OpenGK-org/ecu-reverse-engineering/5wy19/MCU.kicad_sch

## KiCad design 5wy19/MCU.kicad_sch (2025-10-28)

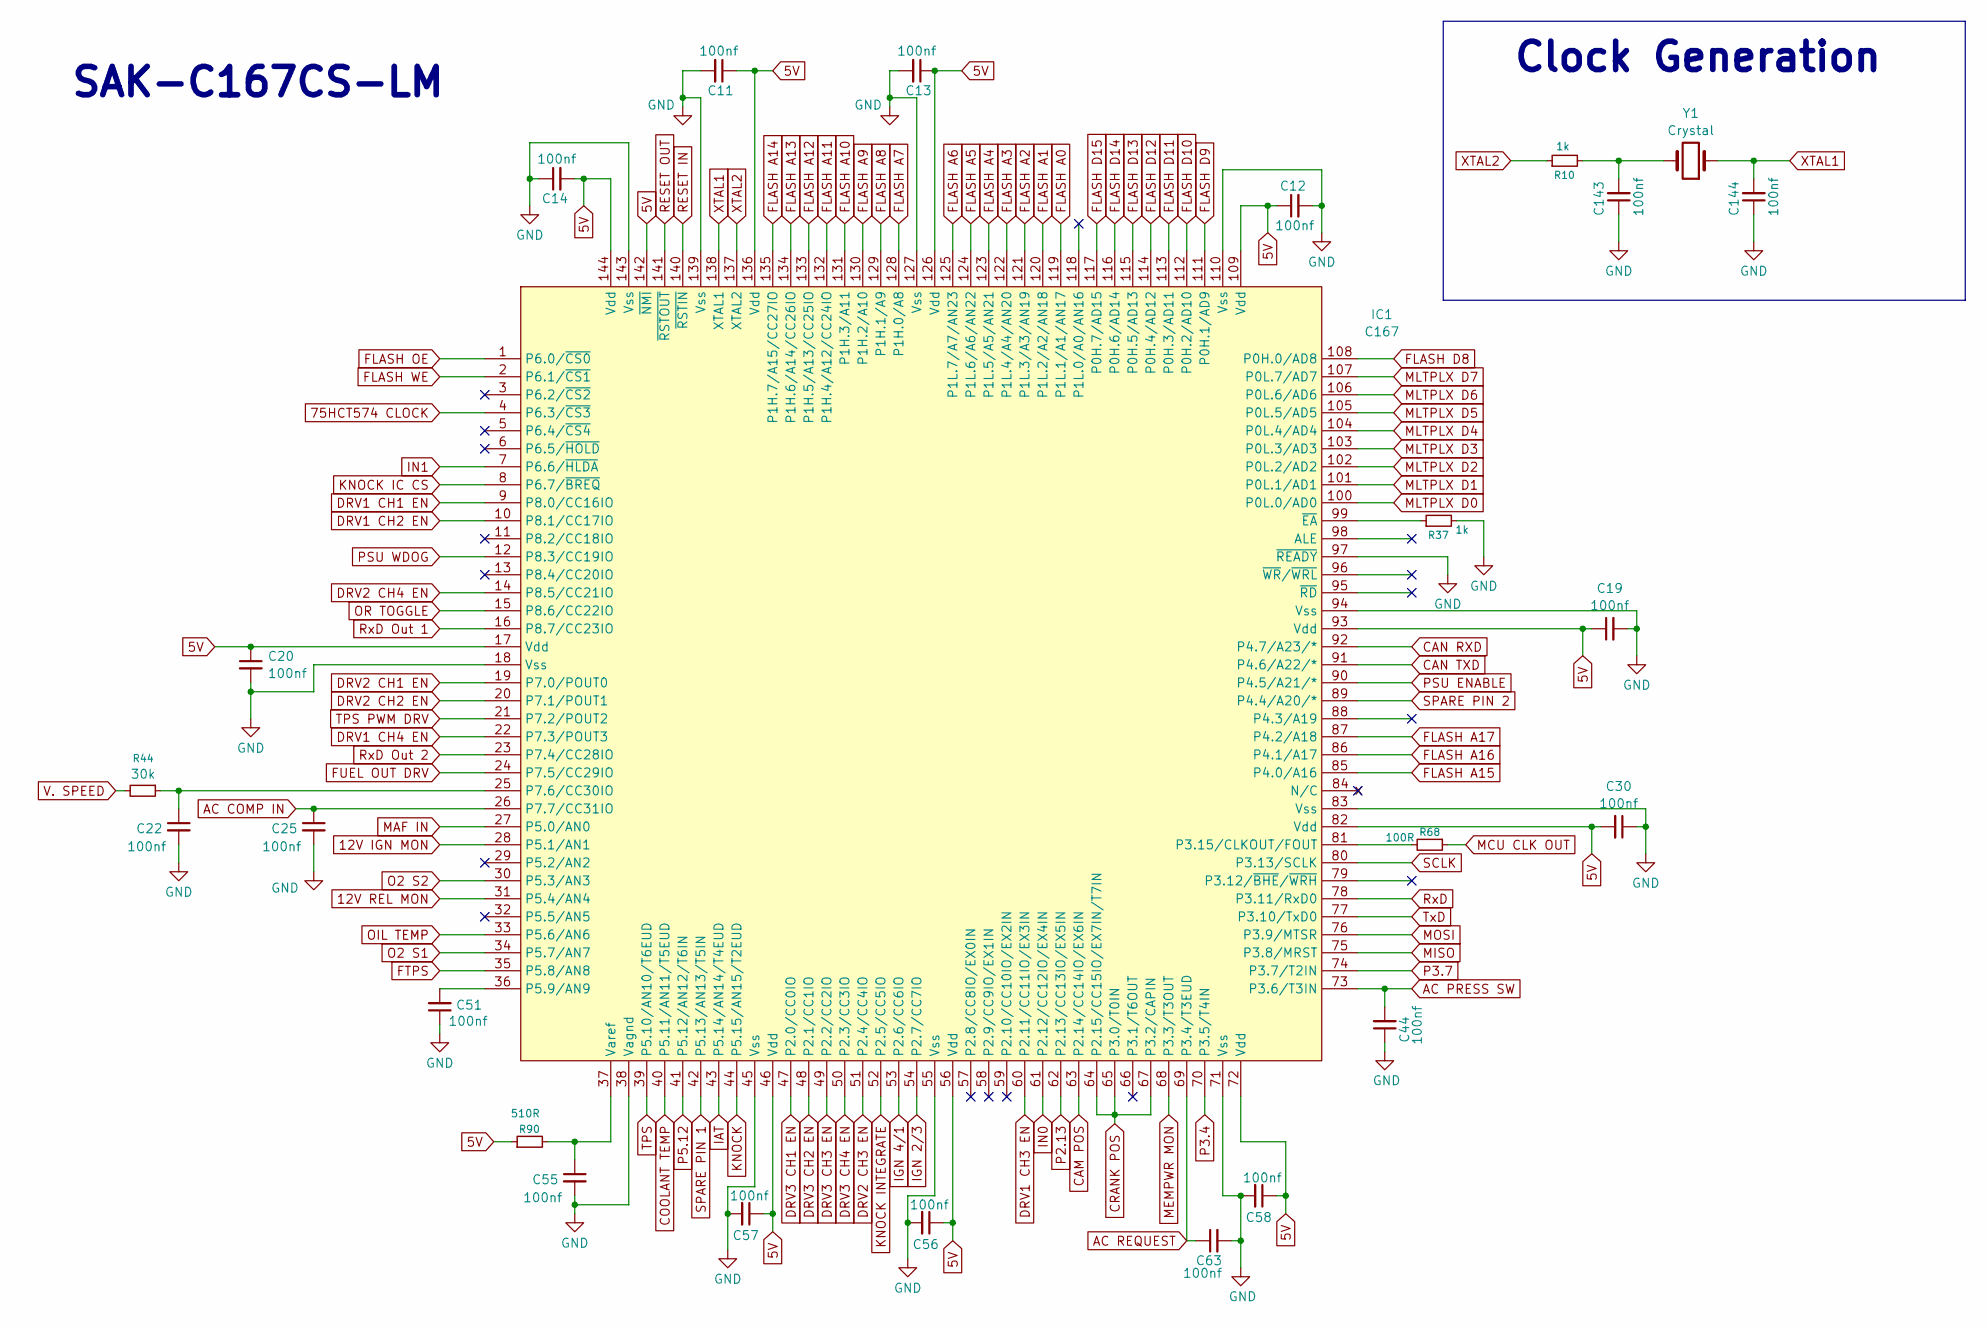
[picture p1: schematic MCU.kicad_sch]

Parts:
C11, C12, C13, C14, C19, C20, C22, C25, C30, C44, C51, C55, C56, C57, C58, C63, C143, C144: 100nf
IC1: C167
R10, R37: 1k
R44: 30k
R68: 100R
R90: 510R
Y1: Crystal

Connections:
5V: C11.1, C12.1, C13.1, C14.2, C19.1, C20.1, C30.2, C56.1, C57.1, C58.1, IC1.17 (Vdd), IC1.46 (Vdd), IC1.56 (Vdd), IC1.72 (Vdd), IC1.82 (Vdd), IC1.93 (Vdd), IC1.109 (Vdd), IC1.126 (Vdd), IC1.136 (Vdd), IC1.142 (~NMI), IC1.144 (Vdd), R90.1
12V IGN MON: IC1.28 (P5.1/AN1)
12V REL MON: IC1.31 (P5.4/AN4)
75HCT574 CLOCK: IC1.4 (P6.3/~CS3)
AC COMP IN: C25.1, IC1.26 (P7.7/CC31IO)
AC PRESS SW: C44.2, IC1.73 (P3.6/T3IN)
AC REQUEST: C63.1, IC1.69 (P3.4/T3EUD)
CAM POS: IC1.63 (P2.14/CC14IO/EX6IN)
CAN RXD: IC1.92 (P4.7/A23/*)
CAN TXD: IC1.91 (P4.6/A22/*)
COOLANT TEMP: IC1.40 (P5.11/AN11/T5EUD)
CRANK POS: IC1.64 (P2.15/CC15IO/EX7IN/T7IN), IC1.65 (P3.0/T0IN), IC1.67 (P3.2/CAPIN)
DRV1 CH1 EN: IC1.9 (P8.0/CC16IO)
DRV1 CH2 EN: IC1.10 (P8.1/CC17IO)
DRV1 CH3 EN: IC1.60 (P2.11/CC11IO/EX3IN)
DRV1 CH4 EN: IC1.22 (P7.3/POUT3)
DRV2 CH1 EN: IC1.19 (P7.0/POUT0)
DRV2 CH2 EN: IC1.20 (P7.1/POUT1)
DRV2 CH3 EN: IC1.51 (P2.4/CC4IO)
DRV2 CH4 EN: IC1.14 (P8.5/CC21IO)
DRV3 CH1 EN: IC1.47 (P2.0/CC0IO)
DRV3 CH2 EN: IC1.48 (P2.1/CC1IO)
DRV3 CH3 EN: IC1.49 (P2.2/CC2IO)
DRV3 CH4 EN: IC1.50 (P2.3/CC3IO)
FLASH A0: IC1.119 (P1L.1/A1/AN17)
FLASH A1: IC1.120 (P1L.2/A2/AN18)
FLASH A2: IC1.121 (P1L.3/A3/AN19)
FLASH A3: IC1.122 (P1L.4/A4/AN20)
FLASH A4: IC1.123 (P1L.5/A5/AN21)
FLASH A5: IC1.124 (P1L.6/A6/AN22)
FLASH A6: IC1.125 (P1L.7/A7/AN23)
FLASH A7: IC1.128 (P1H.0/A8)
FLASH A8: IC1.129 (P1H.1/A9)
FLASH A9: IC1.130 (P1H.2/A10)
FLASH A10: IC1.131 (P1H.3/A11)
FLASH A11: IC1.132 (P1H.4/A12/CC24IO)
FLASH A12: IC1.133 (P1H.5/A13/CC25IO)
FLASH A13: IC1.134 (P1H.6/A14/CC26IO)
FLASH A14: IC1.135 (P1H.7/A15/CC27IO)
FLASH A15: IC1.85 (P4.0/A16)
FLASH A16: IC1.86 (P4.1/A17)
FLASH A17: IC1.87 (P4.2/A18)
FLASH D8: IC1.108 (P0H.0/AD8)
FLASH D9: IC1.111 (P0H.1/AD9)
FLASH D10: IC1.112 (P0H.2/AD10)
FLASH D11: IC1.113 (P0H.3/AD11)
FLASH D12: IC1.114 (P0H.4/AD12)
FLASH D13: IC1.115 (P0H.5/AD13)
FLASH D14: IC1.116 (P0H.6/AD14)
FLASH D15: IC1.117 (P0H.7/AD15)
FLASH OE: IC1.1 (P6.0/~CS0)
FLASH WE: IC1.2 (P6.1/~CS1)
FTPS: IC1.35 (P5.8/AN8)
FUEL OUT DRV: IC1.24 (P7.5/CC29IO)
GND: C11.2, C12.2, C13.2, C14.1, C19.2, C20.2, C22.2, C25.2, C30.1, C44.1, C51.1, C55.2, C56.2, C57.2, C58.2, C63.2, C143.1, C144.1, IC1.18 (Vss), IC1.38 (Vagnd), IC1.45 (Vss), IC1.55 (Vss), IC1.71 (Vss), IC1.83 (Vss), IC1.94 (Vss), IC1.97 (~READY), IC1.110 (Vss), IC1.127 (Vss), IC1.139 (Vss), IC1.143 (Vss), R37.2
IAT: IC1.43 (P5.14/AN14/T4EUD)
IGN 2/3: IC1.54 (P2.7/CC7IO)
IGN 4/1: IC1.53 (P2.6/CC6IO)
IN0: IC1.61 (P2.12/CC12IO/EX4IN)
IN1: IC1.7 (P6.6/~HLDA)
KNOCK: IC1.44 (P5.15/AN15/T2EUD)
KNOCK IC CS: IC1.8 (P6.7/~BREQ)
KNOCK INTEGRATE: IC1.52 (P2.5/CC5IO)
MAF IN: IC1.27 (P5.0/AN0)
MCU CLK OUT: R68.1
MEMPWR MON: IC1.68 (P3.3/T3OUT)
MISO: IC1.75 (P3.8/MRST)
MLTPLX D0: IC1.100 (P0L.0/AD0)
MLTPLX D1: IC1.101 (P0L.1/AD1)
MLTPLX D2: IC1.102 (P0L.2/AD2)
MLTPLX D3: IC1.103 (P0L.3/AD3)
MLTPLX D4: IC1.104 (P0L.4/AD4)
MLTPLX D5: IC1.105 (P0L.5/AD5)
MLTPLX D6: IC1.106 (P0L.6/AD6)
MLTPLX D7: IC1.107 (P0L.7/AD7)
MOSI: IC1.76 (P3.9/MTSR)
unnamed: C22.1, IC1.25 (P7.6/CC30IO), R44.1
unnamed: C51.2, IC1.36 (P5.9/AN9)
unnamed: C55.1, IC1.37 (Varef), R90.2
unnamed: C143.2, R10.2, Y1.2
unnamed: IC1.81 (P3.15/CLKOUT/FOUT), R68.2
unnamed: IC1.99 (~EA), R37.1
O2 S1: IC1.34 (P5.7/AN7)
O2 S2: IC1.30 (P5.3/AN3)
OIL TEMP: IC1.33 (P5.6/AN6)
OR TOGGLE: IC1.15 (P8.6/CC22IO)
P2.13: IC1.62 (P2.13/CC13IO/EX5IN)
P3.4: IC1.70 (P3.5/T4IN)
P3.7: IC1.74 (P3.7/T2IN)
P5.12: IC1.41 (P5.12/AN12/T6IN)
PSU ENABLE: IC1.90 (P4.5/A21/*)
PSU WDOG: IC1.12 (P8.3/CC19IO)
RESET IN: IC1.140 (~RSTIN)
RESET OUT: IC1.141 (~RSTOUT)
RxD: IC1.78 (P3.11/RxD0)
RxD Out 1: IC1.16 (P8.7/CC23IO)
RxD Out 2: IC1.23 (P7.4/CC28IO)
SCLK: IC1.80 (P3.13/SCLK)
SPARE PIN 1: IC1.42 (P5.13/AN13/T5IN)
SPARE PIN 2: IC1.89 (P4.4/A20/*)
TPS: IC1.39 (P5.10/AN10/T6EUD)
TPS PWM DRV: IC1.21 (P7.2/POUT2)
TxD: IC1.77 (P3.10/TxD0)
V. SPEED: R44.2
XTAL1: C144.2, IC1.138 (XTAL1), Y1.1
XTAL2: IC1.137 (XTAL2), R10.1

Notes on the sheet:
Clock Generation
SAK-C167CS-LM
