OpenGK-org/ecu-reverse-engineering/5wy19/can.kicad_sch

## KiCad design 5wy19/can.kicad_sch (2025-10-28)

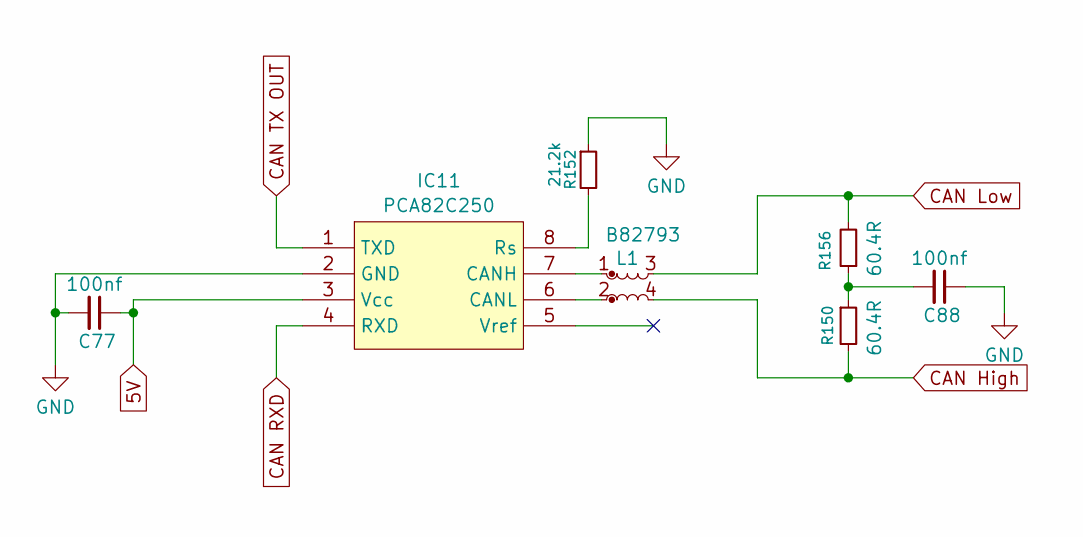
[picture p2: schematic can.kicad_sch]

Parts:
C77, C88: 100nf
IC11: PCA82C250
L1: B82793
R150, R156: 60.4R
R152: 21.2k

Connections:
5V: C77.1, IC11.3 (Vcc)
CAN High: L1.4, R150.2
CAN Low: L1.3, R156.2
CAN RXD: IC11.4 (RXD)
CAN TX OUT: IC11.1 (TXD)
GND: C77.2, C88.1, IC11.2 (GND), R152.1
unnamed: C88.2, R150.1, R156.1
unnamed: IC11.6 (CANL), L1.2
unnamed: IC11.7 (CANH), L1.1
unnamed: IC11.8 (Rs), R152.2
