OpenGK-org/ecu-reverse-engineering/5wy19/connector.kicad_sch

## KiCad design 5wy19/connector.kicad_sch (2025-10-28)

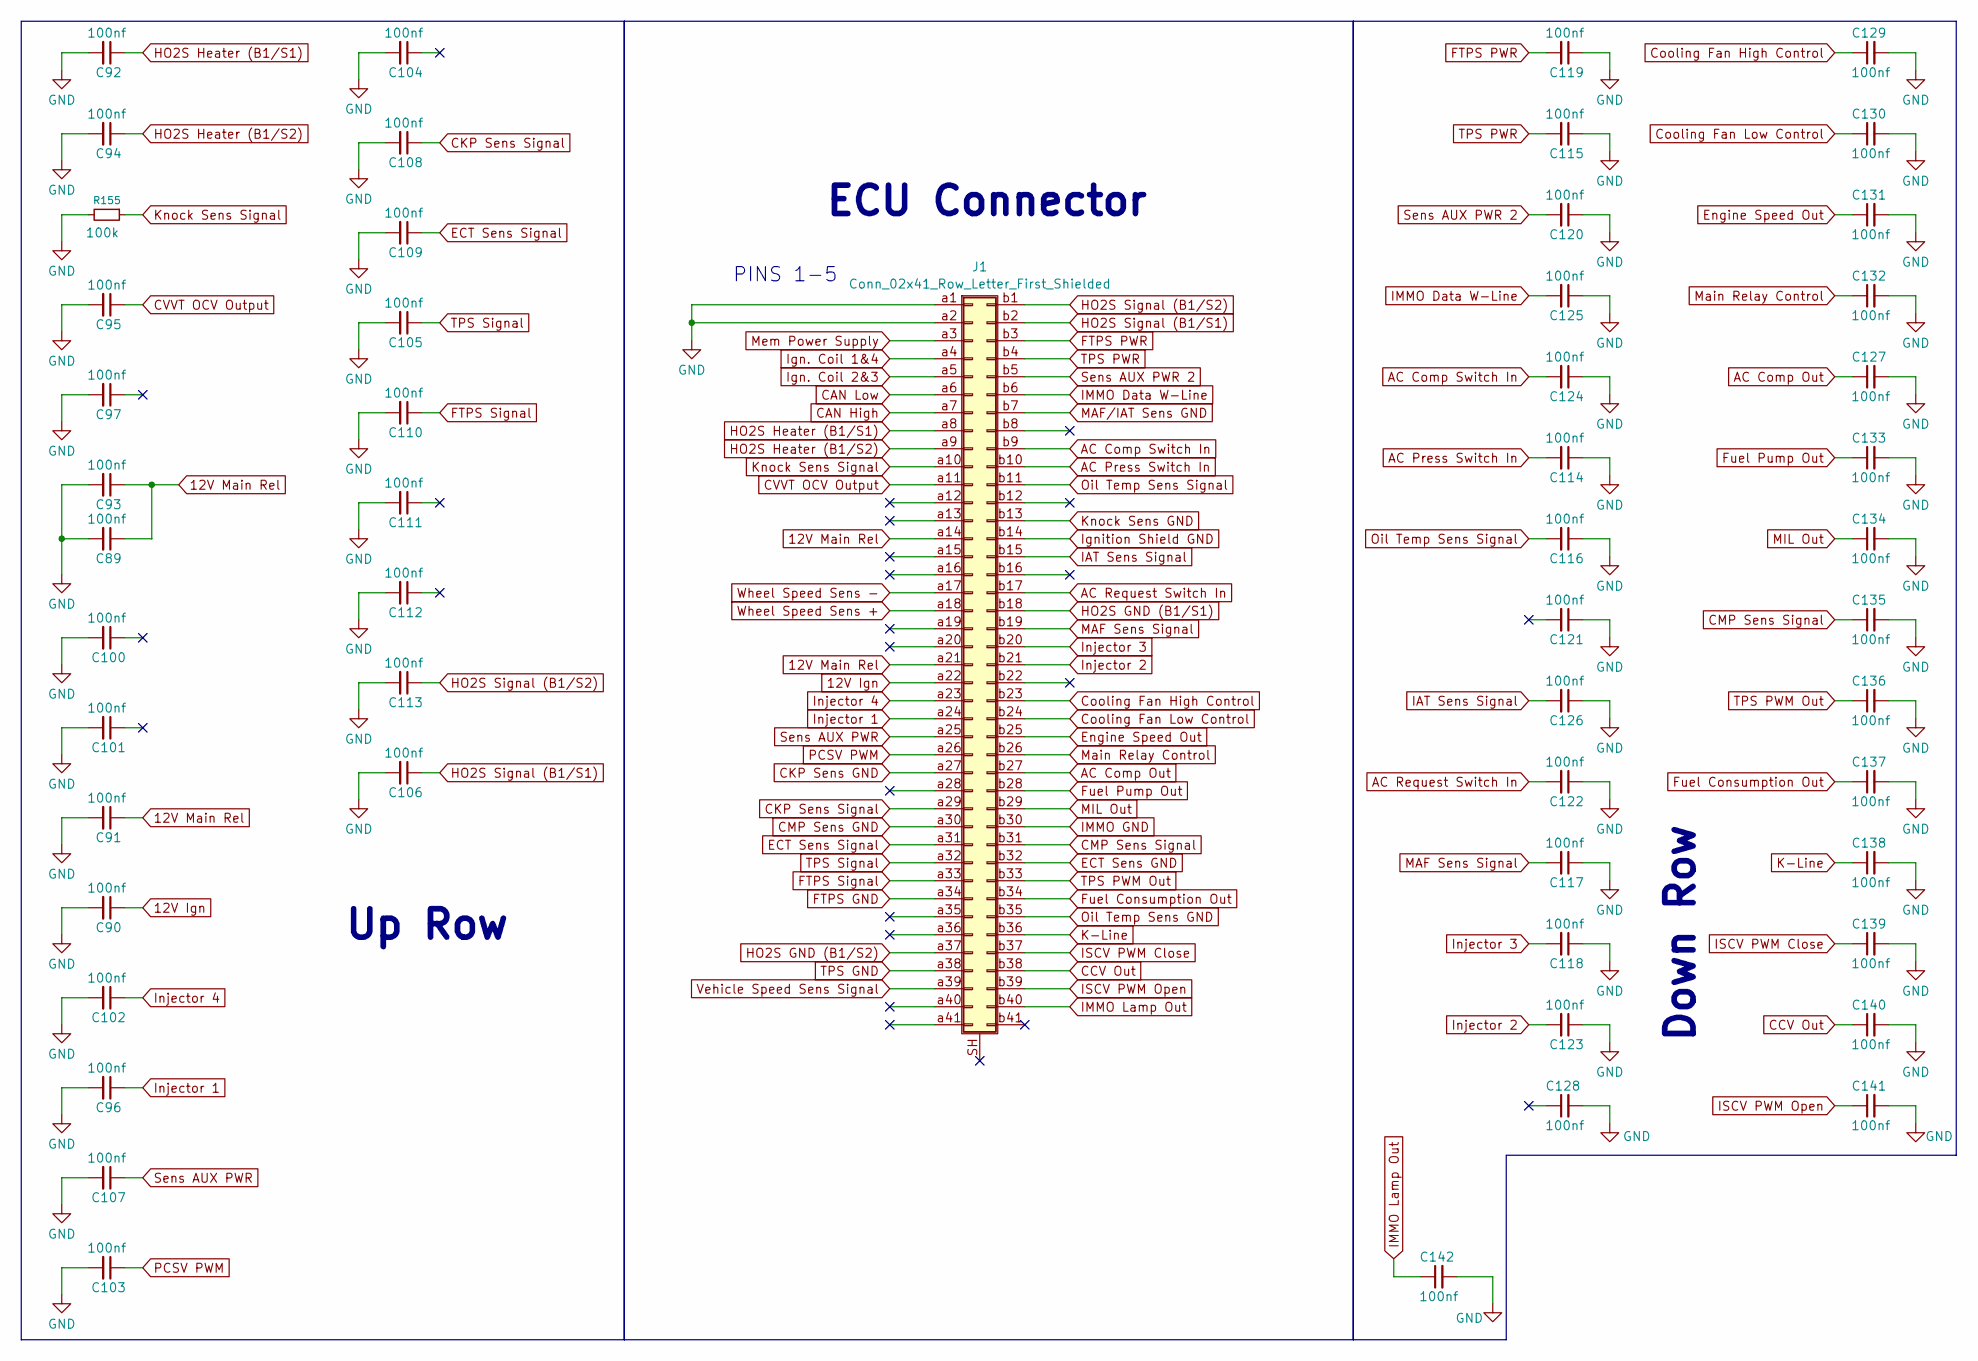
[picture p3: schematic connector.kicad_sch]

Parts:
C89, C90, C91, C92, C93, C94, C95, C96, C97, C100, C101, C102, C103, C104, C105, C106, C107, C108, C109, C110, C111, C112, C113, C114, C115, C116, C117, C118, C119, C120, C121, C122, C123, C124, C125, C126, C127, C128, C129, C130, C131, C132, C133, C134, C135, C136, C137, C138, C139, C140, C141, C142: 100nf
J1: Conn_02x41_Row_Letter_First_Shielded
R155: 100k

Connections:
12V Ign: C90.1, J1.a22
12V Main Rel: C89.1, C91.1, C93.1, J1.a14, J1.a21
AC Comp Out: C127.1, J1.b27
AC Comp Switch In: C124.2, J1.b9
AC Press Switch In: C114.2, J1.b10
AC Request Switch In: C122.2, J1.b17
CAN High: J1.a7
CAN Low: J1.a6
CCV Out: C140.1, J1.b38
CKP Sens GND: J1.a27
CKP Sens Signal: C108.1, J1.a29
CMP Sens GND: J1.a30
CMP Sens Signal: C135.1, J1.b31
CVVT OCV Output: C95.1, J1.a11
Cooling Fan High Control: C129.1, J1.b23
Cooling Fan Low Control: C130.1, J1.b24
ECT Sens GND: J1.b32
ECT Sens Signal: C109.1, J1.a31
Engine Speed Out: C131.1, J1.b25
FTPS GND: J1.a34
FTPS PWR: C119.2, J1.b3
FTPS Signal: C110.1, J1.a33
Fuel Consumption Out: C137.1, J1.b34
Fuel Pump Out: C133.1, J1.b28
GND: C89.2, C90.2, C91.2, C92.2, C93.2, C94.2, C95.2, C96.2, C97.2, C100.2, C101.2, C102.2, C103.2, C104.2, C105.2, C106.2, C107.2, C108.2, C109.2, C110.2, C111.2, C112.2, C113.2, C114.1, C115.1, C116.1, C117.1, C118.1, C119.1, C120.1, C121.1, C122.1, C123.1, C124.1, C125.1, C126.1, C127.2, C128.2, C129.2, C130.2, C131.2, C132.2, C133.2, C134.2, C135.2, C136.2, C137.2, C138.2, C139.2, C140.2, C141.2, C142.2, J1.a1, J1.a2, R155.2
HO2S GND (B1/S1): J1.b18
HO2S GND (B1/S2): J1.a37
HO2S Heater (B1/S1): C92.1, J1.a8
HO2S Heater (B1/S2): C94.1, J1.a9
HO2S Signal (B1/S1): C106.1, J1.b2
HO2S Signal (B1/S2): C113.1, J1.b1
IAT Sens Signal: C126.2, J1.b15
IMMO Data W-Line: C125.2, J1.b6
IMMO GND: J1.b30
IMMO Lamp Out: C142.1, J1.b40
ISCV PWM Close: C139.1, J1.b37
ISCV PWM Open: C141.1, J1.b39
Ign. Coil 1&4: J1.a4
Ign. Coil 2&3: J1.a5
Ignition Shield GND: J1.b14
Injector 1: C96.1, J1.a24
Injector 2: C123.2, J1.b21
Injector 3: C118.2, J1.b20
Injector 4: C102.1, J1.a23
K-Line: C138.1, J1.b36
Knock Sens GND: J1.b13
Knock Sens Signal: J1.a10, R155.1
MAF Sens Signal: C117.2, J1.b19
MAF/IAT Sens GND: J1.b7
MIL Out: C134.1, J1.b29
Main Relay Control: C132.1, J1.b26
Mem Power Supply: J1.a3
Oil Temp Sens GND: J1.b35
Oil Temp Sens Signal: C116.2, J1.b11
PCSV PWM: C103.1, J1.a26
Sens AUX PWR: C107.1, J1.a25
Sens AUX PWR 2: C120.2, J1.b5
TPS GND: J1.a38
TPS PWM Out: C136.1, J1.b33
TPS PWR: C115.2, J1.b4
TPS Signal: C105.1, J1.a32
Vehicle Speed Sens Signal: J1.a39
Wheel Speed Sens +: J1.a18
Wheel Speed Sens -: J1.a17

Notes on the sheet:
ECU Connector
PINS 1-5
Up Row
Down Row
