OpenGK-org/ecu-reverse-engineering/5wy19/flash.kicad_sch

## KiCad design 5wy19/flash.kicad_sch (2025-10-28)

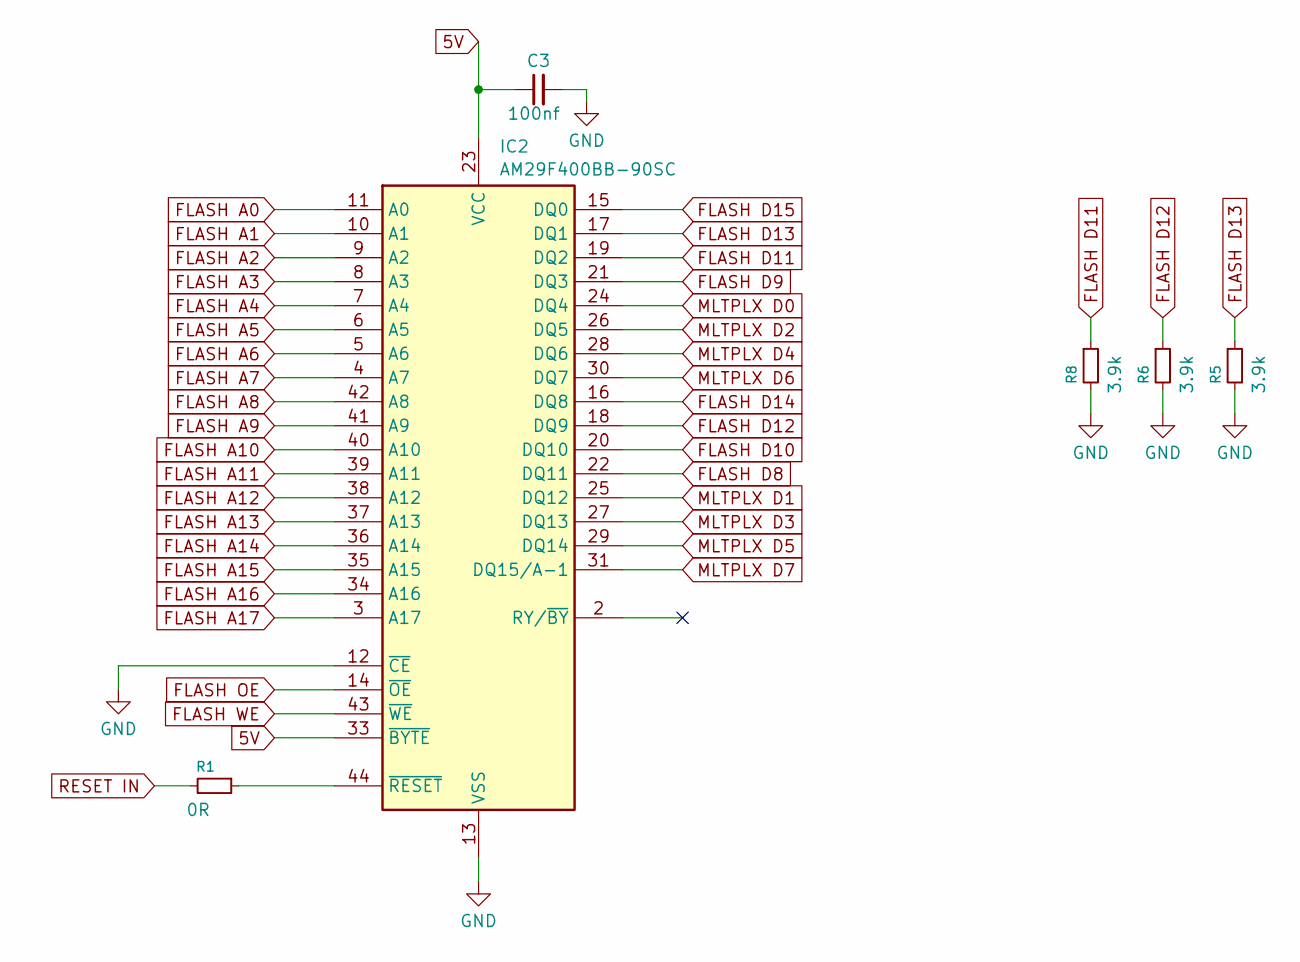
[picture p4: schematic flash.kicad_sch]

Parts:
C3: 100nf
IC2: AM29F400BB-90SC; SOP-44_13.3x28.2mm_P1.27mm
R1: 0R
R5, R6, R8: 3.9k

Connections:
5V: C3.1, IC2.23 (VCC), IC2.33 (~BYTE)
FLASH A0: IC2.11 (A0)
FLASH A1: IC2.10 (A1)
FLASH A2: IC2.9 (A2)
FLASH A3: IC2.8 (A3)
FLASH A4: IC2.7 (A4)
FLASH A5: IC2.6 (A5)
FLASH A6: IC2.5 (A6)
FLASH A7: IC2.4 (A7)
FLASH A8: IC2.42 (A8)
FLASH A9: IC2.41 (A9)
FLASH A10: IC2.40 (A10)
FLASH A11: IC2.39 (A11)
FLASH A12: IC2.38 (A12)
FLASH A13: IC2.37 (A13)
FLASH A14: IC2.36 (A14)
FLASH A15: IC2.35 (A15)
FLASH A16: IC2.34 (A16)
FLASH A17: IC2.3 (A17)
FLASH D8: IC2.22 (DQ11)
FLASH D9: IC2.21 (DQ3)
FLASH D10: IC2.20 (DQ10)
FLASH D11: IC2.19 (DQ2), R8.1
FLASH D12: IC2.18 (DQ9), R6.1
FLASH D13: IC2.17 (DQ1), R5.1
FLASH D14: IC2.16 (DQ8)
FLASH D15: IC2.15 (DQ0)
FLASH OE: IC2.14 (~OE)
FLASH WE: IC2.43 (~WE)
GND: C3.2, IC2.12 (~CE), IC2.13 (VSS), IC2.32 (VSS), R5.2, R6.2, R8.2
MLTPLX D0: IC2.24 (DQ4)
MLTPLX D1: IC2.25 (DQ12)
MLTPLX D2: IC2.26 (DQ5)
MLTPLX D3: IC2.27 (DQ13)
MLTPLX D4: IC2.28 (DQ6)
MLTPLX D5: IC2.29 (DQ14)
MLTPLX D6: IC2.30 (DQ7)
MLTPLX D7: IC2.31 (DQ15/A-1)
unnamed: IC2.44 (~RESET), R1.1
RESET IN: R1.2
