OpenGK-org/ecu-reverse-engineering/5wy19/igadrv.kicad_sch

## KiCad design 5wy19/igadrv.kicad_sch (2025-10-28)

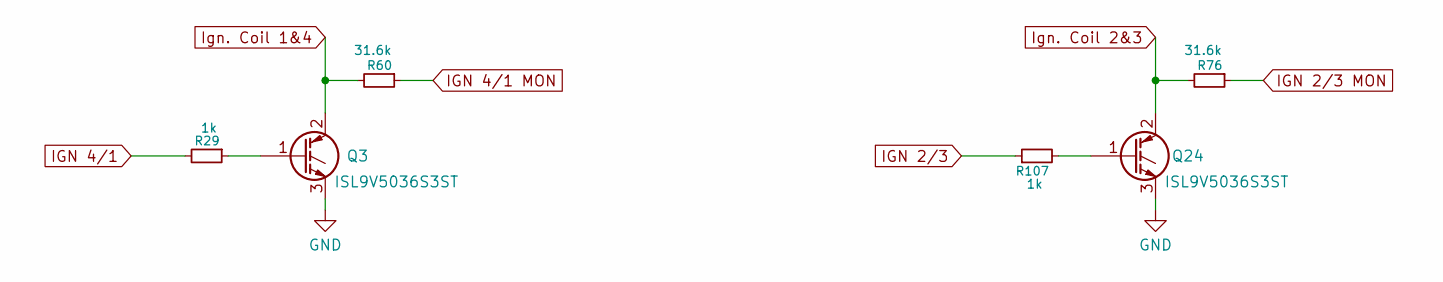
[picture p5: schematic igadrv.kicad_sch]

Parts:
Q3, Q24: ISL9V5036S3ST
R29, R107: 1k
R60, R76: 31.6k

Connections:
GND: Q3.3 (E), Q24.3 (E)
IGN 2/3: R107.1
IGN 2/3 MON: R76.1
IGN 4/1: R29.2
IGN 4/1 MON: R60.1
Ign. Coil 1&4: Q3.2 (C), R60.2
Ign. Coil 2&3: Q24.2 (C), R76.2
unnamed: Q3.1 (G), R29.1
unnamed: Q24.1 (G), R107.2
