OpenGK-org/ecu-reverse-engineering/5wy19/iodriv.kicad_sch

## KiCad design 5wy19/iodriv.kicad_sch (2025-10-28)

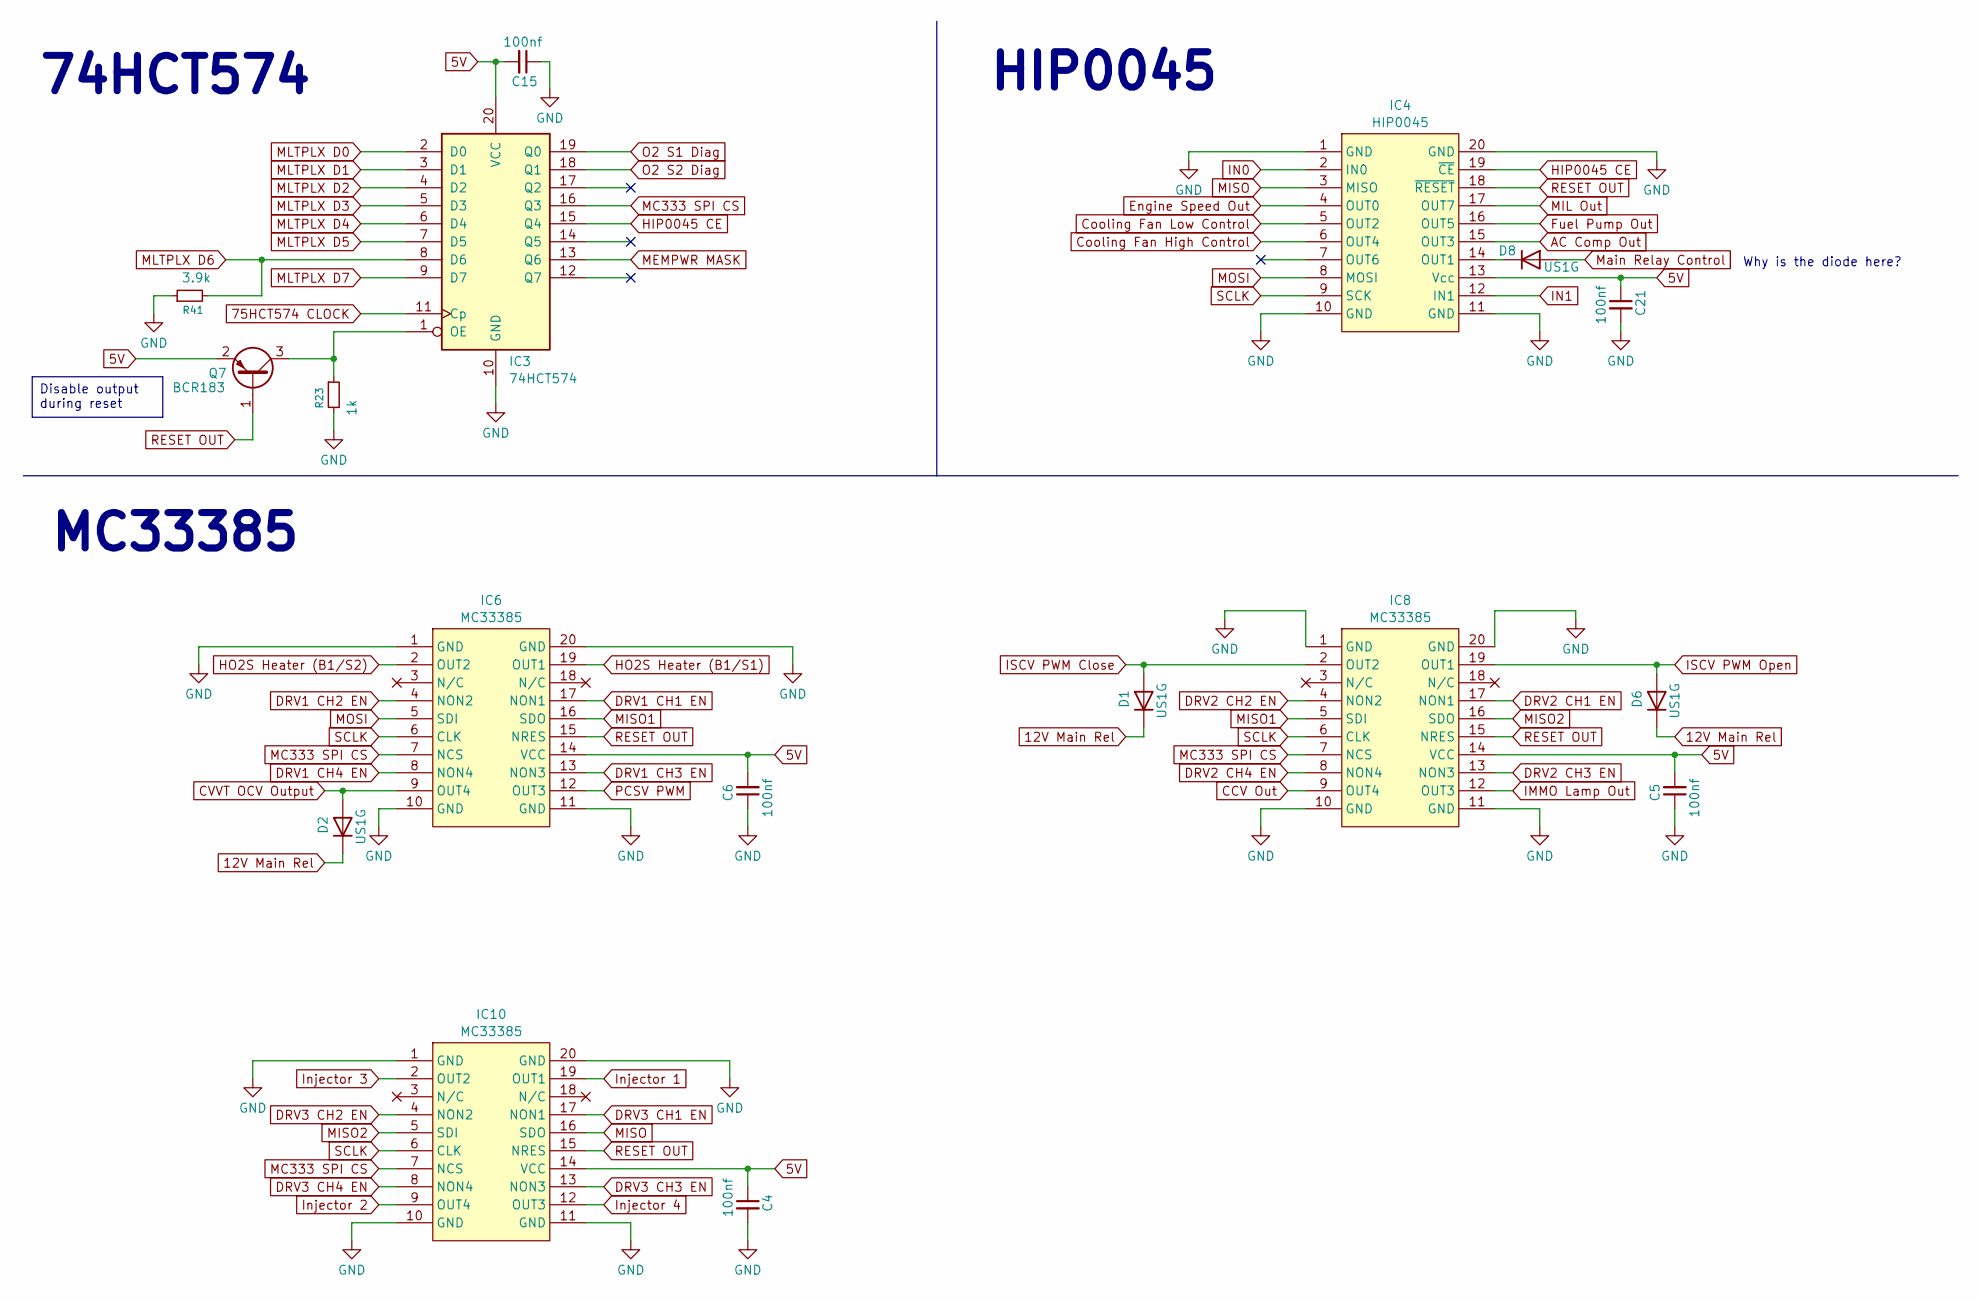
[picture p6: schematic iodriv.kicad_sch]

Parts:
C4, C5, C6, C15, C21: 100nf
D1, D2, D6, D8: US1G; D_SMA
IC3: 74HCT574
IC4: HIP0045
IC6, IC8, IC10: MC33385
Q7: BCR183; SOT-23
R23: 1k
R41: 3.9k

Connections:
5V: C4.1, C5.2, C6.2, C15.2, C21.1, IC3.20 (VCC), IC4.13 (Vcc), IC6.14 (VCC), IC8.14 (VCC), IC10.14 (VCC), Q7.2 (E)
12V Main Rel: D1.1 (K), D2.1 (K), D6.1 (K)
75HCT574 CLOCK: IC3.11 (Cp)
AC Comp Out: IC4.15 (OUT3)
CCV Out: IC8.9 (OUT4)
CVVT OCV Output: D2.2 (A), IC6.9 (OUT4)
Cooling Fan High Control: IC4.6 (OUT4)
Cooling Fan Low Control: IC4.5 (OUT2)
DRV1 CH1 EN: IC6.17 (NON1)
DRV1 CH2 EN: IC6.4 (NON2)
DRV1 CH3 EN: IC6.13 (NON3)
DRV1 CH4 EN: IC6.8 (NON4)
DRV2 CH1 EN: IC8.17 (NON1)
DRV2 CH2 EN: IC8.4 (NON2)
DRV2 CH3 EN: IC8.13 (NON3)
DRV2 CH4 EN: IC8.8 (NON4)
DRV3 CH1 EN: IC10.17 (NON1)
DRV3 CH2 EN: IC10.4 (NON2)
DRV3 CH3 EN: IC10.13 (NON3)
DRV3 CH4 EN: IC10.8 (NON4)
Engine Speed Out: IC4.4 (OUT0)
Fuel Pump Out: IC4.16 (OUT5)
GND: C4.2, C5.1, C6.1, C15.1, C21.2, IC3.10 (GND), IC4.1 (GND), IC4.10 (GND), IC4.11 (GND), IC4.20 (GND), IC6.1 (GND), IC6.10 (GND), IC6.11 (GND), IC6.20 (GND), IC8.1 (GND), IC8.10 (GND), IC8.11 (GND), IC8.20 (GND), IC10.1 (GND), IC10.10 (GND), IC10.11 (GND), IC10.20 (GND), R23.2, R41.1
HIP0045 CE: IC3.15 (Q4), IC4.19 (~CE)
HO2S Heater (B1/S1): IC6.19 (OUT1)
HO2S Heater (B1/S2): IC6.2 (OUT2)
IMMO Lamp Out: IC8.12 (OUT3)
IN0: IC4.2 (IN0)
IN1: IC4.12 (IN1)
ISCV PWM Close: D1.2 (A), IC8.2 (OUT2)
ISCV PWM Open: D6.2 (A), IC8.19 (OUT1)
Injector 1: IC10.19 (OUT1)
Injector 2: IC10.9 (OUT4)
Injector 3: IC10.2 (OUT2)
Injector 4: IC10.12 (OUT3)
MC333 SPI CS: IC3.16 (Q3), IC6.7 (NCS), IC8.7 (NCS), IC10.7 (NCS)
MEMPWR MASK: IC3.13 (Q6)
MIL Out: IC4.17 (OUT7)
MISO: IC4.3 (MISO), IC10.16 (SDO)
MISO1: IC6.16 (SDO), IC8.5 (SDI)
MISO2: IC8.16 (SDO), IC10.5 (SDI)
MLTPLX D0: IC3.2 (D0)
MLTPLX D1: IC3.3 (D1)
MLTPLX D2: IC3.4 (D2)
MLTPLX D3: IC3.5 (D3)
MLTPLX D4: IC3.6 (D4)
MLTPLX D5: IC3.7 (D5)
MLTPLX D6: IC3.8 (D6), R41.2
MLTPLX D7: IC3.9 (D7)
MOSI: IC4.8 (MOSI), IC6.5 (SDI)
Main Relay Control: D8.2 (A)
unnamed: D8.1 (K), IC4.14 (OUT1)
unnamed: IC3.1 (OE), Q7.3 (C), R23.1
O2 S1 Diag: IC3.19 (Q0)
O2 S2 Diag: IC3.18 (Q1)
PCSV PWM: IC6.12 (OUT3)
RESET OUT: IC4.18 (~RESET), IC6.15 (NRES), IC8.15 (NRES), IC10.15 (NRES), Q7.1 (B)
SCLK: IC4.9 (SCK), IC6.6 (CLK), IC8.6 (CLK), IC10.6 (CLK)

Notes on the sheet:
HIP0045
Why is the diode here?
74HCT574
MC33385
Disable output during reset
