OpenGK-org/ecu-reverse-engineering/5wy19/knockctrl.kicad_sch

## KiCad design 5wy19/knockctrl.kicad_sch (2025-10-28)

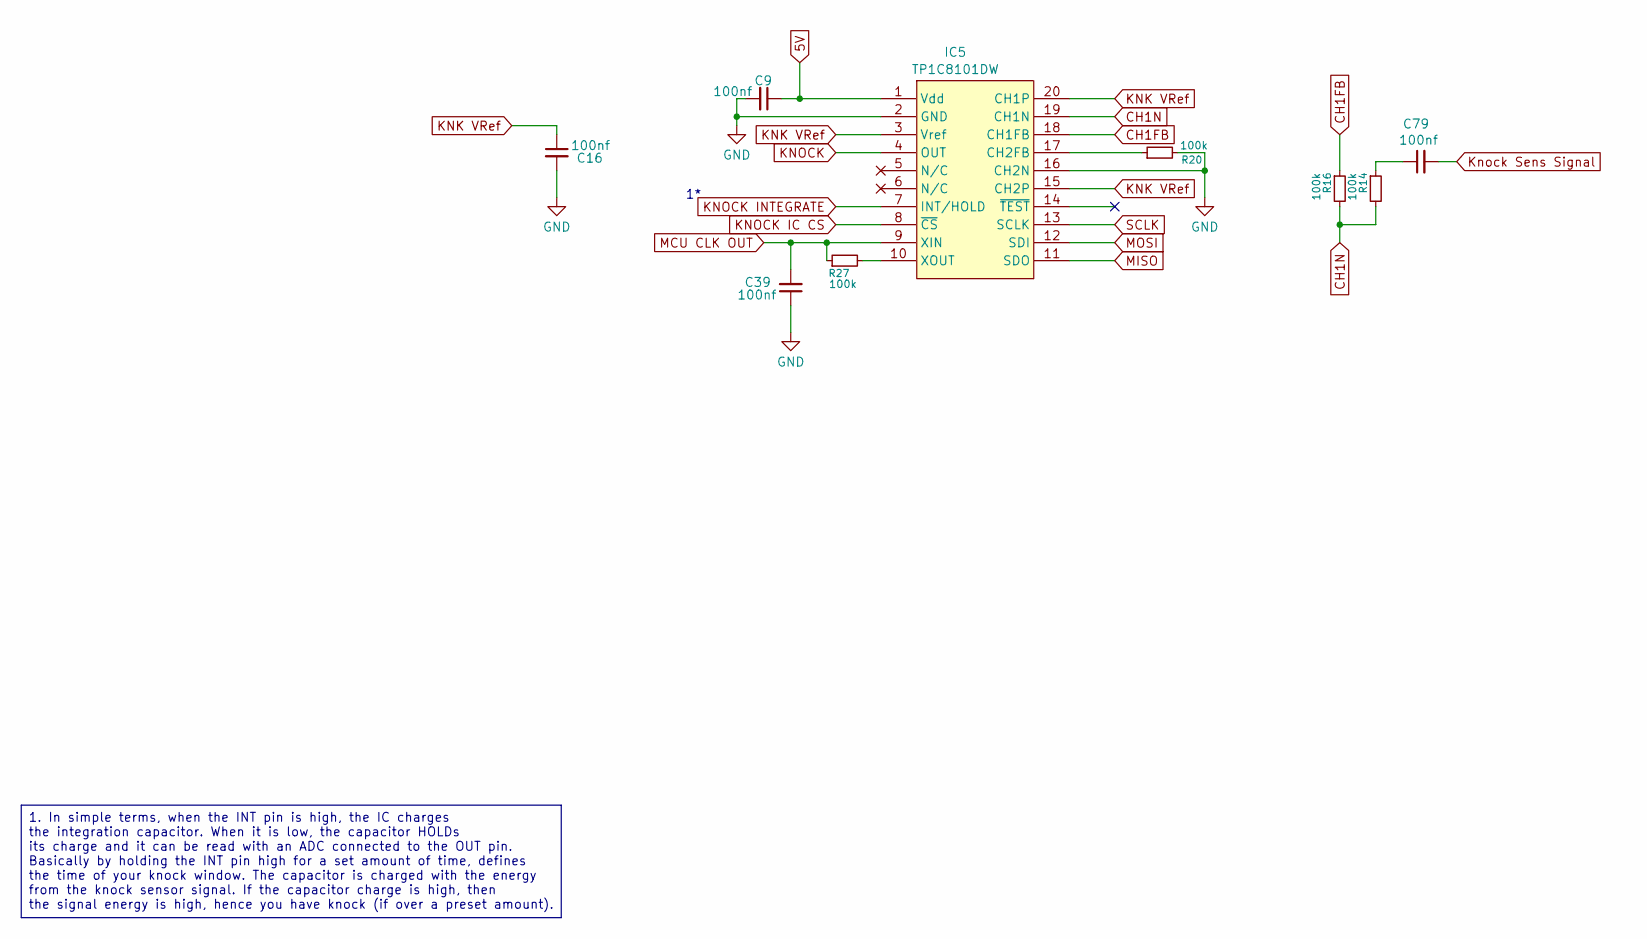
[picture p7: schematic knockctrl.kicad_sch]

Parts:
C9, C16, C39, C79: 100nf
IC5: TP1C8101DW
R14, R16, R20, R27: 100k

Connections:
5V: C9.1, IC5.1 (Vdd)
CH1FB: IC5.18 (CH1FB), R16.1
CH1N: IC5.19 (CH1N), R14.2, R16.2
GND: C9.2, C16.2, C39.1, IC5.2 (GND), IC5.16 (CH2N), R20.2
KNK VRef: C16.1, IC5.3 (Vref), IC5.15 (CH2P), IC5.20 (CH1P)
KNOCK: IC5.4 (OUT)
KNOCK IC CS: IC5.8 (~CS)
KNOCK INTEGRATE: IC5.7 (INT/HOLD)
Knock Sens Signal: C79.2
MCU CLK OUT: C39.2, IC5.9 (XIN), R27.1
MISO: IC5.11 (SDO)
MOSI: IC5.12 (SDI)
unnamed: C79.1, R14.1
unnamed: IC5.10 (XOUT), R27.2
unnamed: IC5.17 (CH2FB), R20.1
SCLK: IC5.13 (SCLK)

Notes on the sheet:
1. In simple terms, when the INT pin is high, the IC charges the integration capacitor. When it is low, the capacitor HOLDs its charge and it can be read with an ADC connected to the OUT pin. Basically by holding the INT pin high for a set amount of time, defines the time of your knock window. The 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
