OpenGK-org/ecu-reverse-engineering/5wy19/logic_ic.kicad_sch

## KiCad design 5wy19/logic_ic.kicad_sch (2025-10-28)

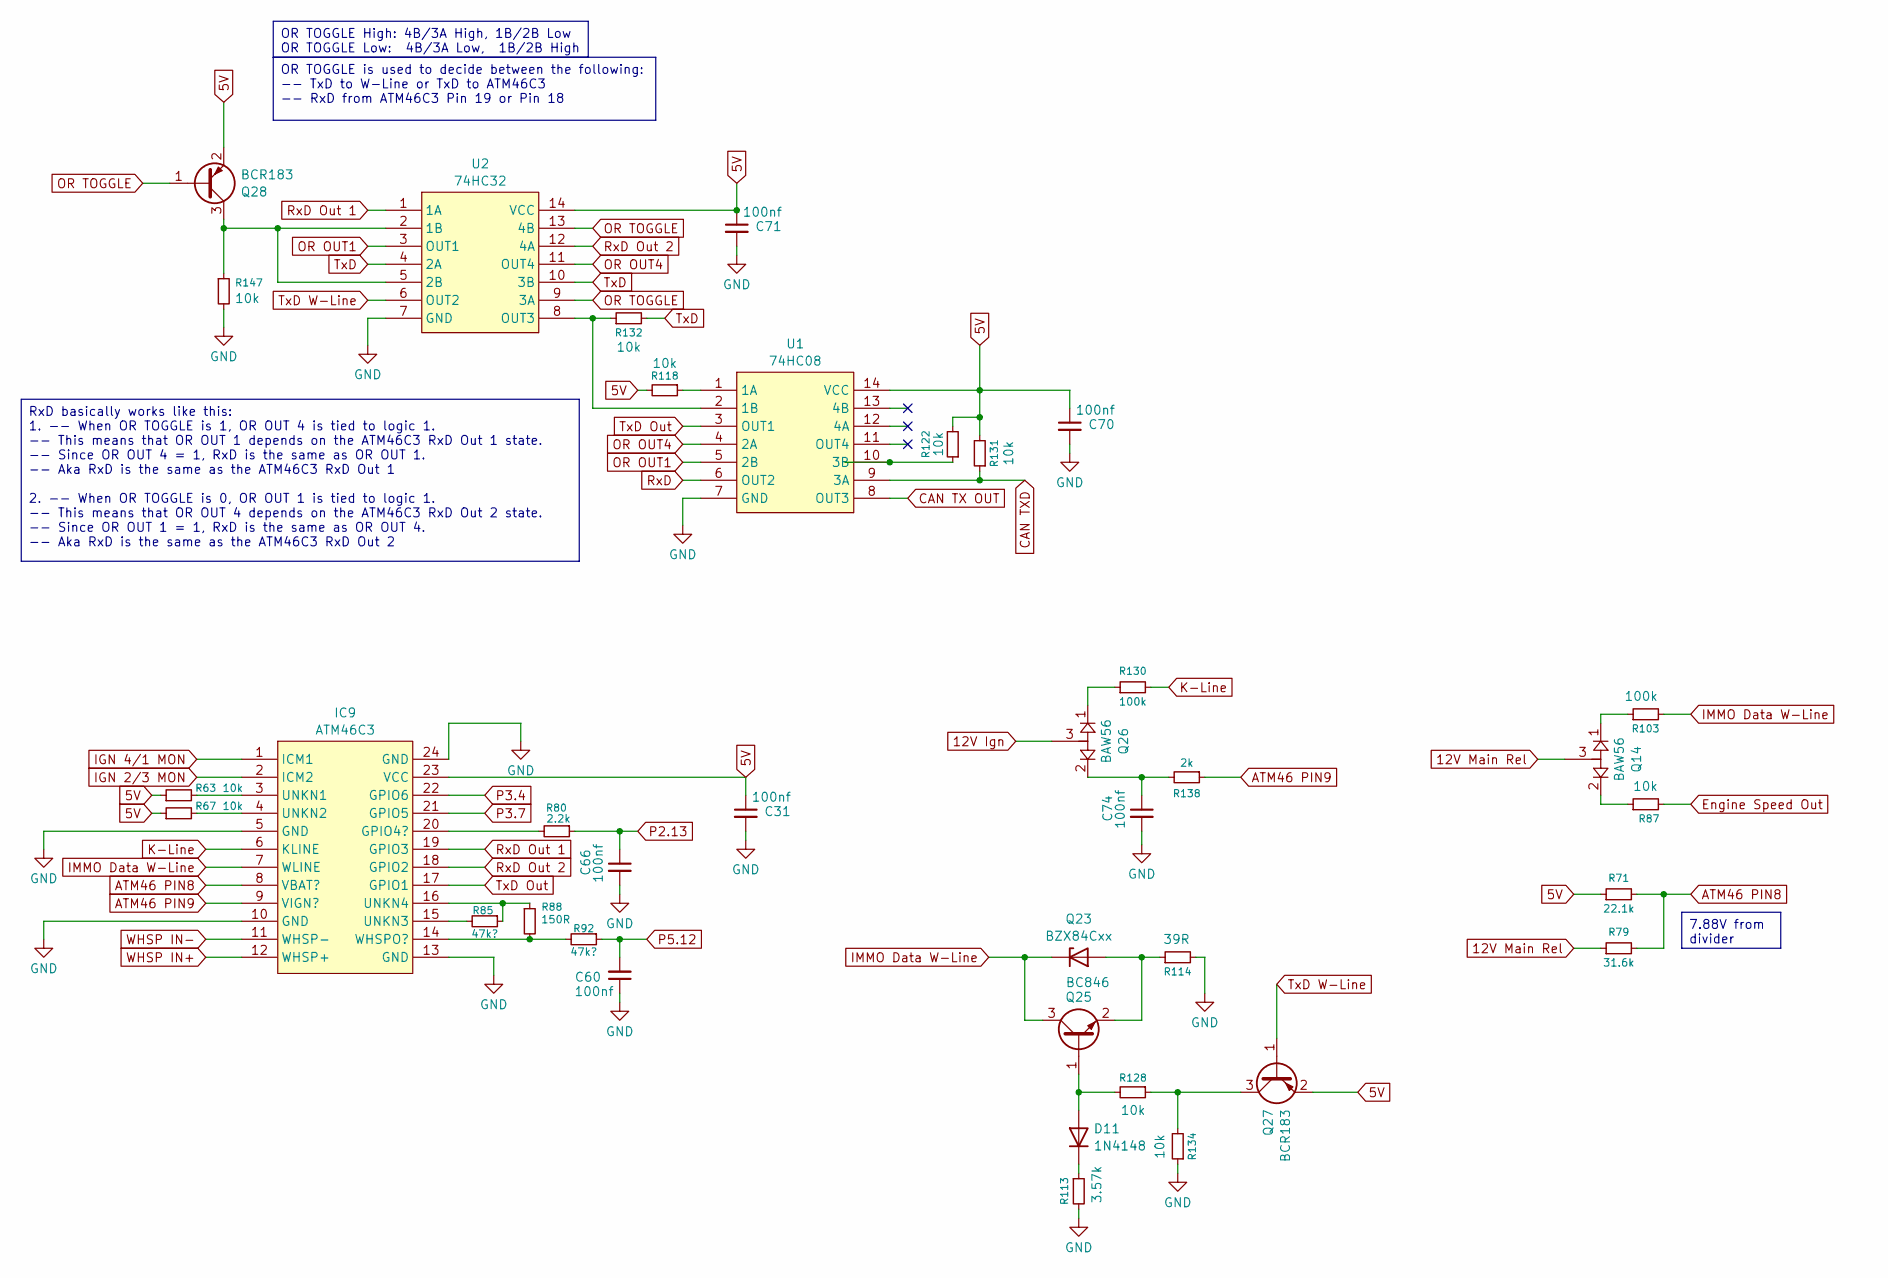
[picture p9: schematic logic_ic.kicad_sch]

Parts:
C31, C60, C66, C70, C71, C74: 100nf
D11: 1N4148; D_DO-35_SOD27_P7.62mm_Horizontal
IC9: ATM46C3
Q14, Q26: BAW56
Q23: BZX84Cxx; SOT-23
Q25: BC846; SOT-23
Q27, Q28: BCR183; SOT-23
R63, R67, R87, R118, R122, R128, R131, R132, R134, R147: 10k
R71: 22.1k
R79: 31.6k
R80: 2.2k
R85, R92: 47k?
R88: 150R
R103, R130: 100k
R113: 3.57k
R114: 39R
R138: 2k
U1: 74HC08
U2: 74HC32

Connections:
5V: C31.1, C70.1, C71.1, IC9.23 (VCC), Q27.2 (E), Q28.2 (E), R63.1, R67.1, R71.1, R118.2, R122.2, R131.2, U1.14 (VCC), U2.14 (VCC)
12V Ign: Q26.3
12V Main Rel: Q14.3, R79.1
ATM46 PIN8: IC9.8 (VBAT?), R71.2, R79.2
ATM46 PIN9: IC9.9 (VIGN?), R138.1
CAN TX OUT: U1.8 (OUT3)
CAN TXD: R131.1, U1.9 (3A)
Engine Speed Out: R87.2
GND: C31.2, C60.1, C66.2, C70.2, C71.2, C74.2, IC9.5 (GND), IC9.10 (GND), IC9.13 (GND), IC9.24 (GND), R113.2, R114.2, R134.1, R147.2, U1.7 (GND), U2.7 (GND)
IGN 2/3 MON: IC9.2 (ICM2)
IGN 4/1 MON: IC9.1 (ICM1)
IMMO Data W-Line: IC9.7 (WLINE), Q23.3 (K), Q25.3 (C), R103.2
K-Line: IC9.6 (KLINE), R130.2
unnamed: C74.1, Q26.2, R138.2
unnamed: D11.1 (K), R113.1
unnamed: D11.2 (A), Q25.1 (B), R128.2
unnamed: IC9.3 (UNKN1), R63.2
unnamed: IC9.4 (UNKN2), R67.2
unnamed: IC9.14 (WHSPO?), R88.2, R92.2
unnamed: IC9.15 (UNKN3), R85.2
unnamed: IC9.16 (UNKN4), R85.1, R88.1
unnamed: IC9.20 (GPIO4?), R80.2
unnamed: Q14.1, R103.1
unnamed: Q14.2, R87.1
unnamed: Q23.1 (A), Q25.2 (E), R114.1
unnamed: Q26.1, R130.1
unnamed: Q27.3 (C), R128.1, R134.2
unnamed: Q28.3 (C), R147.1, U2.2 (1B), U2.5 (2B)
unnamed: R118.1, U1.1 (1A)
unnamed: R122.1, U1.10 (3B)
unnamed: R132.1, U1.2 (1B), U2.8 (OUT3)
OR OUT1: U1.5 (2B), U2.3 (OUT1)
OR OUT4: U1.4 (2A), U2.11 (OUT4)
OR TOGGLE: Q28.1 (B), U2.9 (3A), U2.13 (4B)
P2.13: C66.1, R80.1
P3.4: IC9.22 (GPIO6)
P3.7: IC9.21 (GPIO5)
P5.12: C60.2, R92.1
RxD: U1.6 (OUT2)
RxD Out 1: IC9.19 (GPIO3), U2.1 (1A)
RxD Out 2: IC9.18 (GPIO2), U2.12 (4A)
TxD: R132.2, U2.4 (2A), U2.10 (3B)
TxD Out: IC9.17 (GPIO1), U1.3 (OUT1)
TxD W-Line: Q27.1 (B), U2.6 (OUT2)
WHSP IN+: IC9.12 (WHSP+)
WHSP IN-: IC9.11 (WHSP-)

Notes on the sheet:
OR TOGGLE High: 4B/3A High, 1B/2B Low OR TOGGLE Low: 4B/3A Low, 1B/2B High
7.88V from divider
OR TOGGLE is used to decide between the following: -- TxD to W-Line or TxD to ATM46C3 -- RxD from ATM46C3 Pin 19 or Pin 18
RxD basically works like this: 1. -- When OR TOGGLE is 1, OR OUT 4 is tied to logic 1. -- This means that OR OUT 1 depends on the ATM46C3 RxD Out 1 state. -- Since OR OUT 4 = 1, RxD is the same as OR OUT 1. -- Aka RxD is the same as the ATM46C3 RxD Out 1 2. -- When OR TOGGLE is 0, OR OUT 1 is tied 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
