OpenGK-org/ecu-reverse-engineering/5wy19/pwr.kicad_sch

## KiCad design 5wy19/pwr.kicad_sch (2025-10-28)

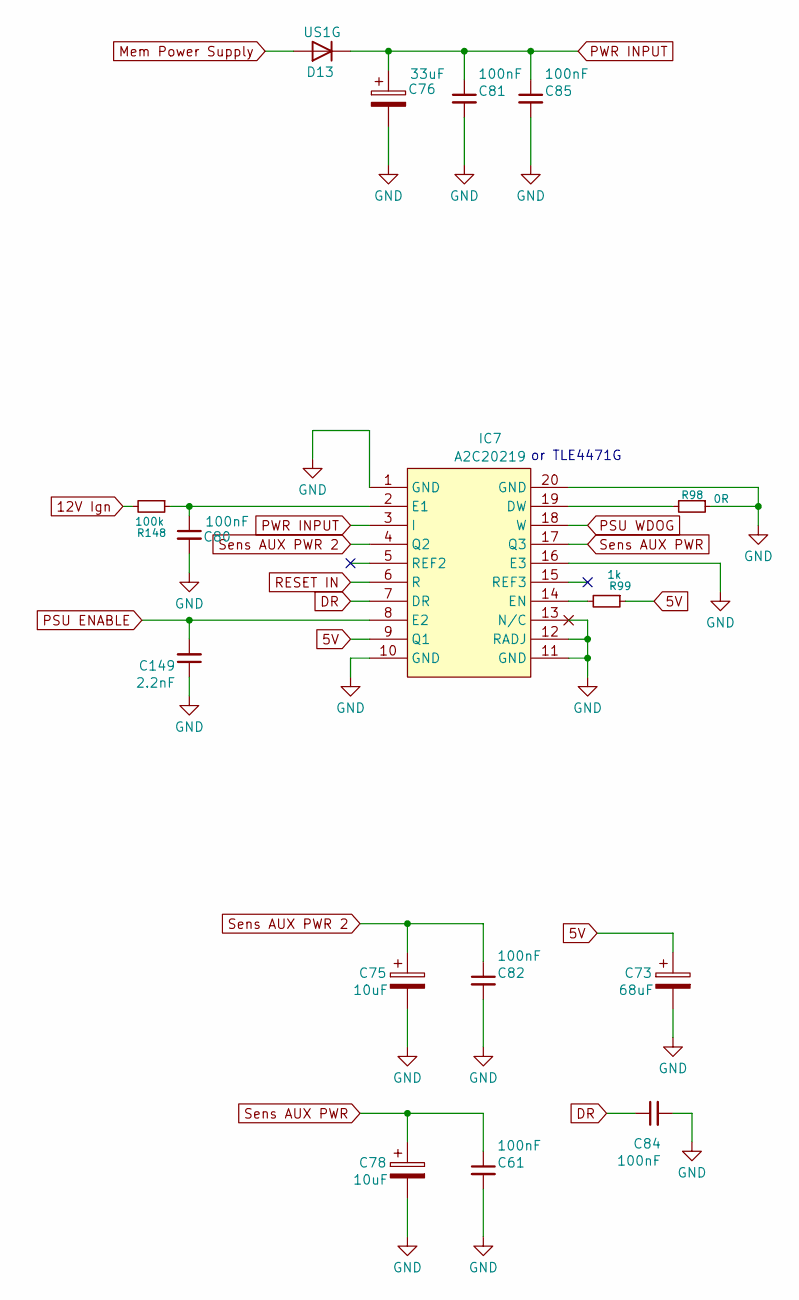
[picture p10: schematic pwr.kicad_sch]

Parts:
C61, C80, C81, C82, C84, C85: 100nF
C73: 68uF
C75, C78: 10uF
C76: 33uF
C149: 2.2nF
D13: US1G; D_SMA
IC7: A2C20219
R98: 0R
R99: 1k
R148: 100k

Connections:
5V: C73.1, IC7.9 (Q1), R99.1
12V Ign: R148.2
DR: C84.1, IC7.7 (DR)
GND: C61.2, C73.2, C75.2, C76.2, C78.2, C80.2, C81.2, C82.2, C84.2, C85.2, C149.1, IC7.1 (GND), IC7.10 (GND), IC7.11 (GND), IC7.12 (RADJ), IC7.13 (N/C), IC7.16 (E3), IC7.20 (GND), R98.1
Mem Power Supply: D13.2 (A)
unnamed: C80.1, IC7.2 (E1), R148.1
unnamed: IC7.14 (EN), R99.2
unnamed: IC7.19 (DW), R98.2
PSU ENABLE: C149.2, IC7.8 (E2)
PSU WDOG: IC7.18 (W)
PWR INPUT: C76.1, C81.1, C85.1, D13.1 (K), IC7.3 (I)
RESET IN: IC7.6 (R)
Sens AUX PWR: C61.1, C78.1, IC7.17 (Q3)
Sens AUX PWR 2: C75.1, C82.1, IC7.4 (Q2)

Notes on the sheet:
or TLE4471G
