OpenGK-org/ecu-reverse-engineering/5wy19/sensor_logic.kicad_sch

## KiCad design 5wy19/sensor_logic.kicad_sch (2025-10-28)

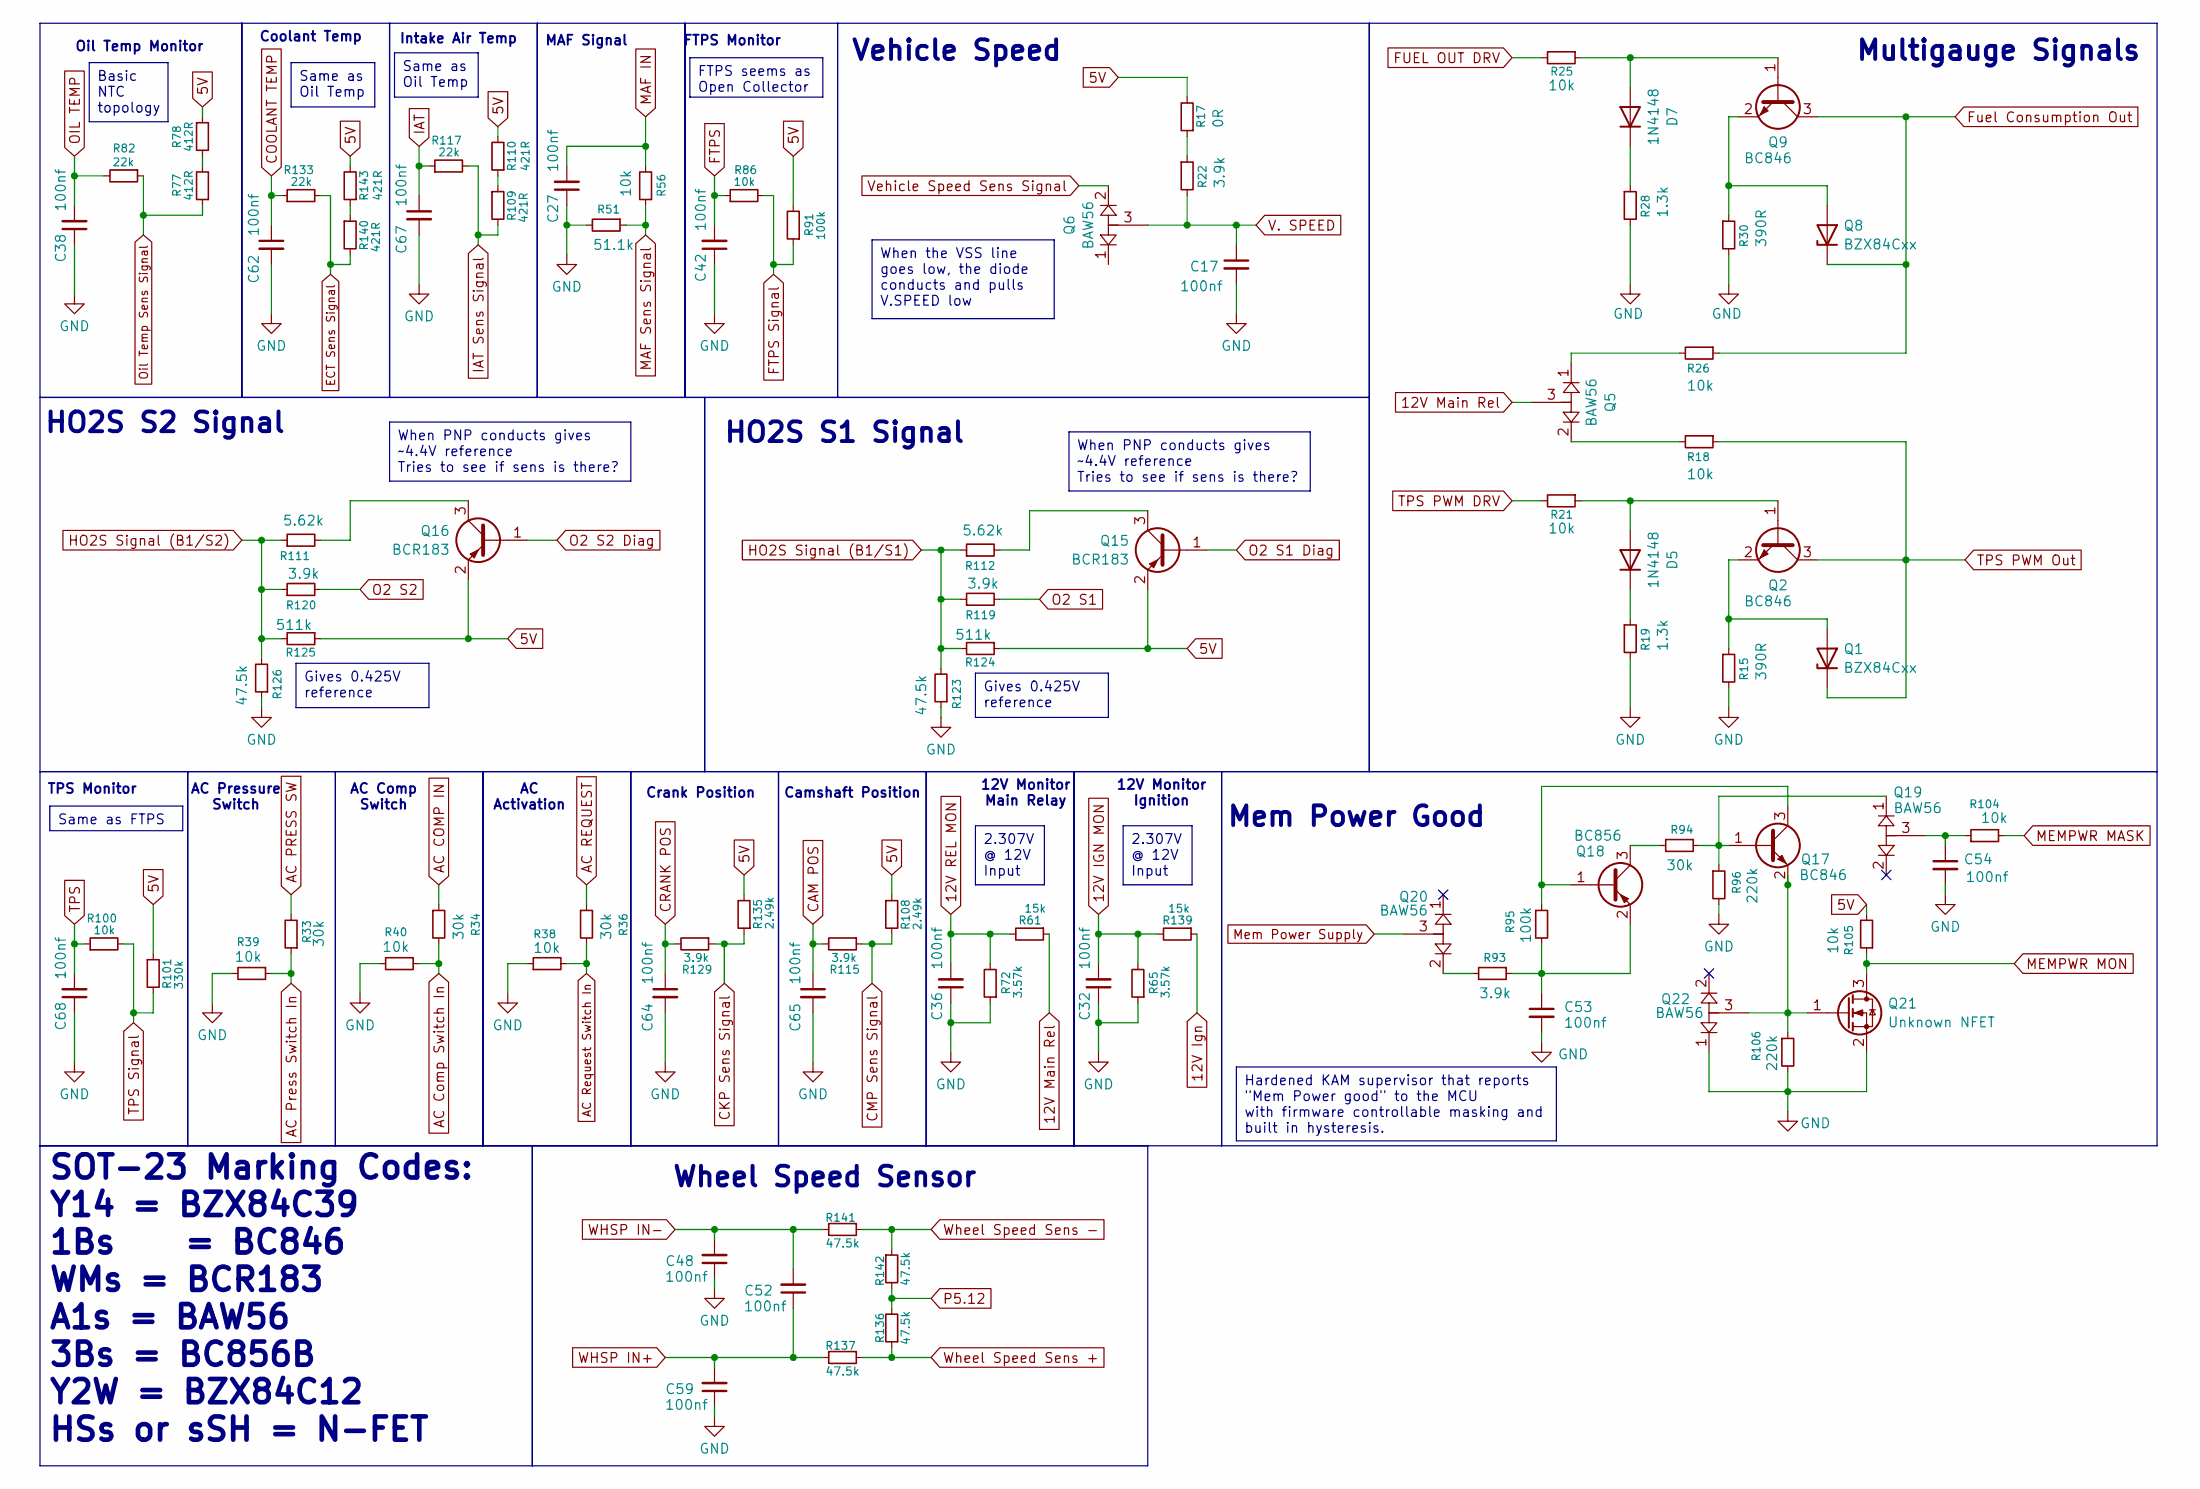
[picture p11: schematic sensor_logic.kicad_sch]

Parts:
C17, C27, C32, C36, C38, C42, C48, C52, C53, C54, C59, C62, C64, C65, C67, C68: 100nf
D5, D7: 1N4148; D_DO-35_SOD27_P7.62mm_Horizontal
Q1, Q8: BZX84Cxx; SOT-23
Q2, Q9, Q17: BC846; SOT-23
Q5, Q6, Q19, Q20, Q22: BAW56
Q15, Q16: BCR183; SOT-23
Q18: BC856; SOT-23
Q21: Unknown NFET; SOT-23
R15, R30: 390R
R17: 0R
R18, R21, R25, R26, R38, R39, R40, R56, R86, R100, R104, R105: 10k
R19, R28: 1.3k
R22, R93, R115, R119, R120, R129: 3.9k
R33, R34, R36, R94: 30k
R51: 51.1k
R61, R139: 15k
R65, R72: 3.57k
R77, R78: 412R
R82, R117, R133: 22k
R91, R95: 100k
R96, R106: 220k
R101: 330k
R108, R135: 2.49k
R109, R110, R140, R143: 421R
R111, R112: 5.62k
R123, R126, R136, R137, R141, R142: 47.5k
R124, R125: 511k

Connections:
5V: Q15.2 (E), Q16.2 (E), R17.2, R78.1, R91.2, R101.1, R105.2, R108.1, R110.2, R124.1, R125.1, R135.2, R143.2
12V IGN MON: C32.2, R65.2, R139.2
12V Ign: R139.1
12V Main Rel: Q5.3, R61.1
12V REL MON: C36.2, R61.2, R72.2
AC COMP IN: R34.1
AC Comp Switch In: R34.2, R40.1
AC PRESS SW: R33.2
AC Press Switch In: R33.1, R39.1
AC REQUEST: R36.1
AC Request Switch In: R36.2, R38.2
CAM POS: C65.1, R115.2
CKP Sens Signal: R129.1, R135.1
CMP Sens Signal: R108.2, R115.1
COOLANT TEMP: C62.1, R133.1
CRANK POS: C64.1, R129.2
ECT Sens Signal: R133.2, R140.2
FTPS: C42.2, R86.1
FTPS Signal: R86.2, R91.1
FUEL OUT DRV: R25.2
Fuel Consumption Out: Q8.3 (K), Q9.3 (C), R26.1
GND: C17.2, C27.1, C32.1, C36.1, C38.1, C42.1, C48.1, C53.2, C54.2, C59.1, C62.2, C64.2, C65.2, C67.2, C68.1, Q21.2 (S), Q22.1, R15.2, R19.2, R28.2, R30.2, R38.1, R39.2, R40.2, R51.2, R65.1, R72.1, R96.2, R106.2, R123.1, R126.1
HO2S Signal (B1/S1): R112.1, R119.1, R123.2, R124.2
HO2S Signal (B1/S2): R111.1, R120.1, R125.2, R126.2
IAT: C67.1, R117.1
IAT Sens Signal: R109.2, R117.2
MAF IN: C27.2, R56.2
MAF Sens Signal: R51.1, R56.1
MEMPWR MASK: R104.2
MEMPWR MON: Q21.3 (D), R105.1
Mem Power Supply: Q20.3
unnamed: C53.1, Q18.2 (E), R93.1, R95.2
unnamed: C54.1, Q19.3, R104.1
unnamed: D5.1 (K), R19.1
unnamed: D5.2 (A), Q2.1 (B), R21.1
unnamed: D7.1 (K), R28.1
unnamed: D7.2 (A), Q9.1 (B), R25.1
unnamed: Q1.1 (A), Q2.2 (E), R15.1
unnamed: Q5.1, R26.2
unnamed: Q5.2, R18.2
unnamed: Q8.1 (A), Q9.2 (E), R30.1
unnamed: Q15.3 (C), R112.2
unnamed: Q16.3 (C), R111.2
unnamed: Q17.1 (B), Q19.1, R94.1, R96.1
unnamed: Q17.2 (E), Q21.1 (G), Q22.3, R106.1
unnamed: Q17.3 (C), Q18.1 (B), R95.1
unnamed: Q18.3 (C), R94.2
unnamed: Q20.2, R93.2
unnamed: R17.1, R22.1
unnamed: R77.2, R78.2
unnamed: R109.1, R110.1
unnamed: R140.1, R143.1
O2 S1: R119.2
O2 S1 Diag: Q15.1 (B)
O2 S2: R120.2
O2 S2 Diag: Q16.1 (B)
OIL TEMP: C38.2, R82.2
Oil Temp Sens Signal: R77.1, R82.1
P5.12: R136.2, R142.2
TPS: C68.2, R100.1
TPS PWM DRV: R21.2
TPS PWM Out: Q1.3 (K), Q2.3 (C), R18.1
TPS Signal: R100.2, R101.2
V. SPEED: C17.1, Q6.3, R22.2
Vehicle Speed Sens Signal: Q6.2
WHSP IN+: C52.1, C59.2, R137.2
WHSP IN-: C48.2, C52.2, R141.2
Wheel Speed Sens +: R136.1, R137.1
Wheel Speed Sens -: R141.1, R142.1

Notes on the sheet:
Wheel Speed Sensor
Multigauge Signals
12V Monitor Main Relay
Crank Position
Mem Power Good
12V Monitor Ignition
TPS Monitor
FTPS Monitor
Coolant Temp
AC Comp Switch
AC Activation
Camshaft Position
Vehicle Speed
Oil Temp Monitor
Intake Air Temp
AC Pressure Switch
HO2S S1 Signal
HO2S S2 Signal
MAF Signal
SOT-23 Marking Codes: Y14 = BZX84C39 1Bs = BC846 WMs = BCR183 A1s = BAW56 3Bs = BC856B Y2W = BZX84C12 HSs or sSH = N-FET
When PNP conducts gives ~4.4V reference Tries to see if sens is there?
Same as FTPS
Gives 0.425V reference
2.307V @ 12V Input
Hardened KAM supervisor that reports "Mem Power good" to the MCU with firmware controllable masking and built in hysteresis.
Same as Oil Temp
FTPS seems as Open Collector
When the VSS line goes low, the diode conducts and pulls V.SPEED low
Basic NTC topology
