OpenGK-org/ecu-reverse-engineering/(commit log)

2025-10-19 Initial commit of 5wy19 SIMK43 4Mbit
    Mapped a few MCU pins to their respective ICs and demystified some logic circuits.
    [5wy19_converted.kicad_sch, MCU.kicad_sch, can.kicad_sch, connector.kicad_sch, flash.kicad_sch, igadrv.kicad_sch, iodriv.kicad_sch, knockctrl.kicad_sch]
2025-10-19 Datasheets for devices
2025-10-19 Gerbers of the board
    [891-萱250721-1.DRL, 891-萱250721-1.GBL, 891-萱250721-1.GBO, 891-萱250721-1.GBP, 891-萱250721-1.GBS, 891-萱250721-1.GKO, 891-萱250721-1.GTL, 891-萱250721-1.GTO]
2025-10-19 Library for symbols of devices on SIMK43
2025-10-19 Further progress on MCU and connected circuits
    Mostly sensors, knock control, some pins from the IO drivers and the unknown AMIS chip
    [5wy19_converted.kicad_sch, MCU.kicad_sch, igadrv.kicad_sch, iodriv.kicad_sch, knockctrl.kicad_sch, logic.kicad_sch, logic_ic.kicad_sch]
2025-10-20 Mapped out more pins of MCU and relevant circuits
    [5wy19_converted.kicad_sch, MCU.kicad_sch, flash.kicad_sch, iodriv.kicad_sch, knockctrl.kicad_sch, logic_ic.kicad_sch, pwr.kicad_sch, sensor_logic.kicad_sch]
2025-10-28 Finished most of the subsystems
    -- MCU finished
    -- Flash finished
    -- Power Supply finished
    -- I/O Drivers finished
    -- CANBUS finished
    -- Knock Control finished
    -- Connector finished
    -- Ignition Driver finished
    -- Sensor Logic mostly finished
    -- Logic ICs need some work
    [5wy19_converted.kicad_sch, MCU.kicad_sch, can.kicad_sch, connector.kicad_sch, flash.kicad_sch, igadrv.kicad_sch, iodriv.kicad_sch, knockctrl.kicad_sch]
2025-10-28 ED DO214 diodes datasheet
2025-10-28 Final schematic (except maybe some oversights)
    [MCU.kicad_sch, can.kicad_sch, connector.kicad_sch, flash.kicad_sch, igadrv.kicad_sch, iodriv.kicad_sch, knockctrl.kicad_sch, logic_ic.kicad_sch]
